Weijie-Lou/DL-14542/project/Hardware/温显UI_T1(转曲）2026092701.pdf

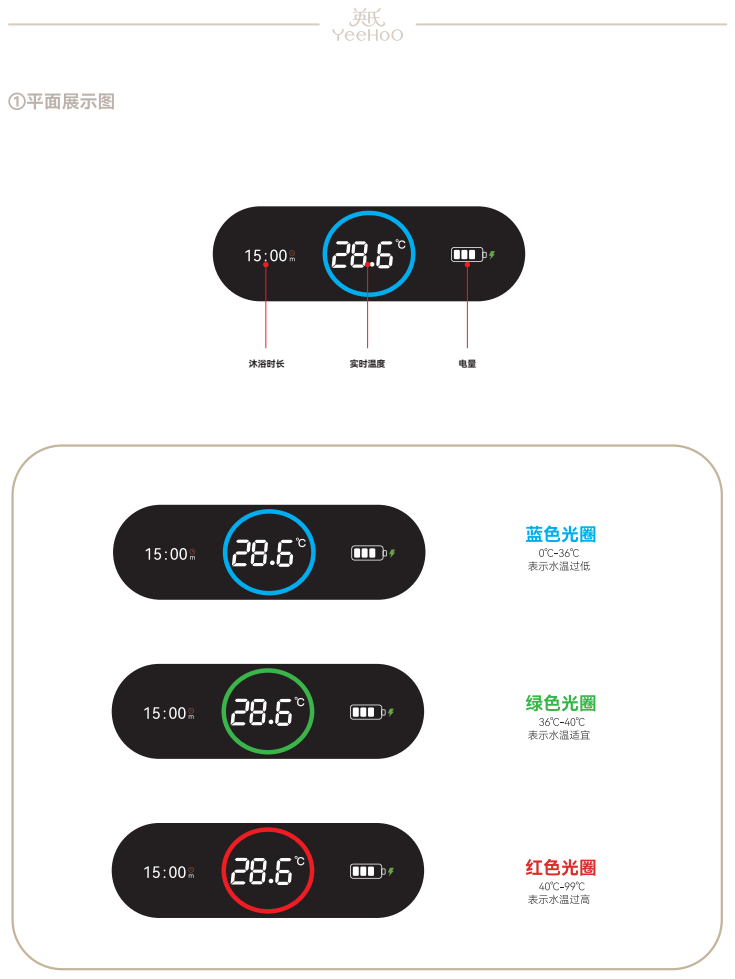
[picture p10: page 1]
沐浴时长; 实时温度

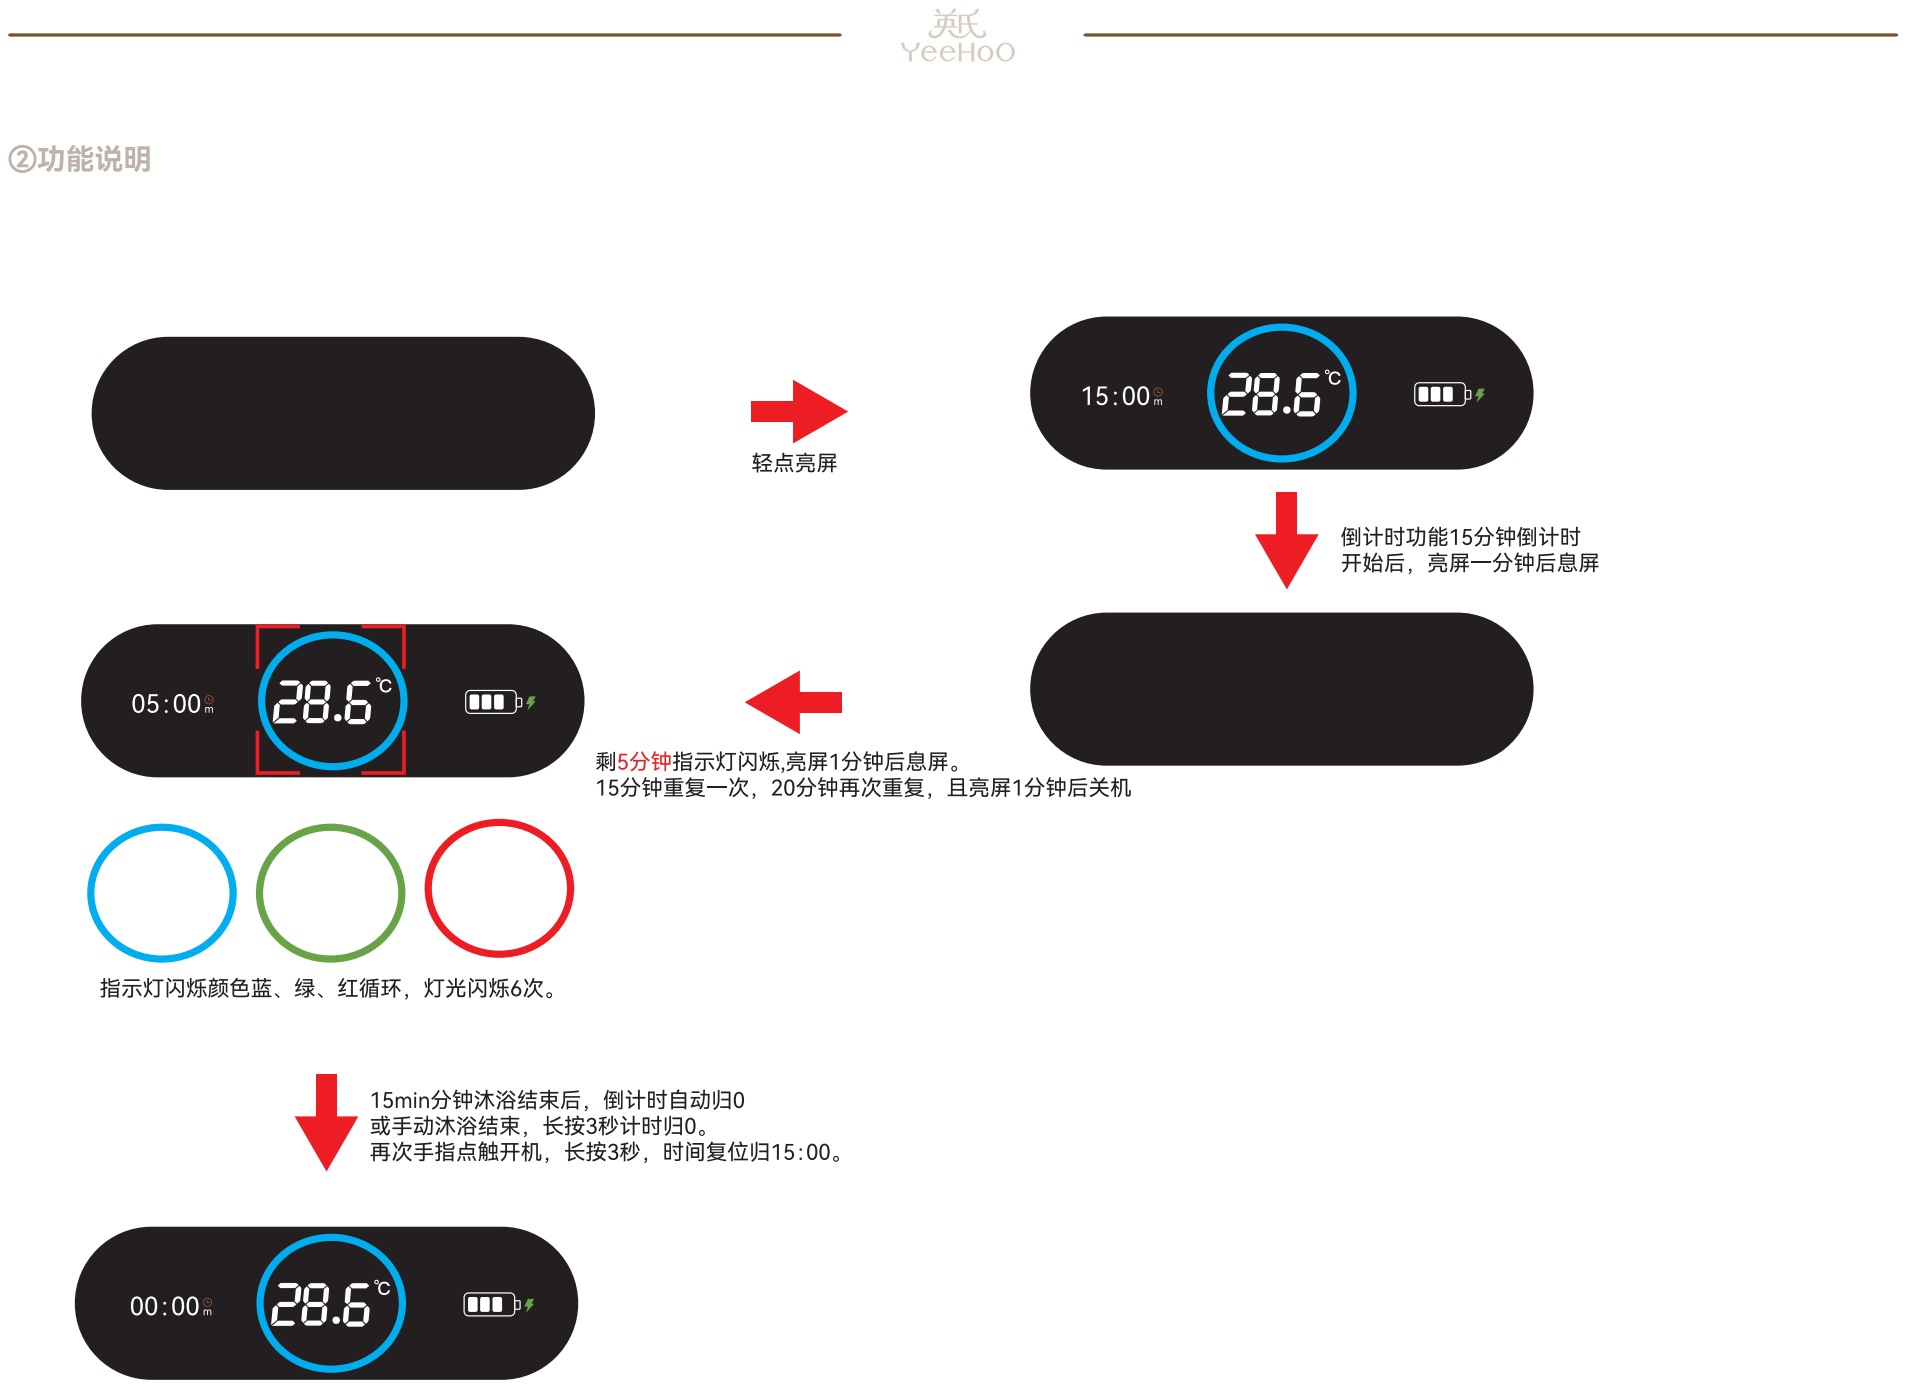
[picture p11: page 2]
