Weijie-Lou/DL-14542/(list of files, drawings)

Other design files:
project/Hardware/DL-14542-V01 20261004.PcbDoc
