Weijie-Lou/DL-14542/project/App/DL-14542/DL-14542/User/adc.c

/**
 * @file    adc.c
 * @brief   NY8BM84A 模数转换(ADC)驱动实现
 * @note
 *   - ADMD  ：ADEN[7] 使能 / START[6] 启动 / GCHS[5] 全局通道 / CHS[4:0] 通道选择
 *   - ADCON1：ADFM[4] 结果格式 / ADCK[3:2] 转换时钟 / VHS[1:0] 参考电压 / EOC 转换完成标志
 *   - ADCR  ：PxCON 端口映射[7:6] / 采样脉冲宽度[3:2] / 转换位数[1:0]
 *   - 转换结果：ADD = (ADDH << 8) | ADDL（12 位）
 */

#include "adc.h"
#include <stdint.h>

/** @brief 初始化 ADC：使能 ADC、选择通道、设置右对齐 / 参考电压 / 转换时钟与 12bit 8Clk 采样
 *  @param ch  采样通道（ADMD[4:0]）
 *  @param ref 参考电压（ADCON1：VHS[1:0] 内部电压 / EVHENB 外部参考）
 *  @param clk 转换时钟（ADCON1：ADCK[3:2]）
 */
void ADC_Init(ADC_Channel_t ch, ADC_Reference_t ref, ADC_Clock_t clk)
{
    ADMD   = C_ADC_En | C_ADC_CH_Dis | ch;   /* 使能 ADC、关闭全局通道、选择通道 */
    ADCON1 = C_ADFM_Right | ref | clk;       /* 结果右对齐 + 参考电压 + 转换时钟 */
    ADCR   = (ADCR & 0xF0u) | C_Sample_8Clk | C_12Bit;  /* 保留 ADCR[7:4]（含 [7:6] PxCON 端口映射，由 GPIO_SET_ANALOG 维护），设采样宽度[3:2]与位数[1:0] */

    ADMDbits.GCHS = 1;                       /* 使能全局 ADC 通道 */
    PIR2bits.ADIF = 0;                       /* 清 ADC 中断标志 */
}

/** @brief 关闭 ADC：ADMD 写 0（清 ADEN 使能与通道选择），避免采样电路常开耗电 */
void ADC_Disable(void)
{
    ADMD = C_ADC_CH_Dis;                     /* ADMD 写 0：关闭 ADEN 使能与通道选择 */
}

/** @brief 启动一次转换并等待完成，返回 12 位结果
 *  @note  查询 EOC 等待（无中断）；超时（约 65535 次空转）时返回上一次的有效结果，
 *         并且首次转换通常需丢弃（切换通道后未稳定），详见 temp.c / battery.c */
uint16_t ADC_Convert(void)
{
    static uint16_t last_result = 0;   /* 上次有效结果（超时保护时返回，避免读数跳变） */
    uint16_t result;
    uint16_t timeout = 0;

    ADMDbits.START = 1;                      /* 启动一次转换 */
    while (ADCON1bits.EOC == 0) {            /* 等待转换完成 */
        if (++timeout == 0u) {               /* 超时保护：约 65535 次空转后放弃，返回上次有效结果 */
            return last_result;
        }
    }
    last_result = result = ((uint16_t)ADDH << 8) | ADDL;   /* 12 位结果 */
    return result;
}
