Weijie-Lou/DL-14542/(commit log)

2026-10-12 代码编辑中
    [DL-14542-V01 20261004.PcbDoc]
2026-10-15 DL-14542 交付固件（校验和 E1271A / NY8BM84A / TSSOP20）
    15 分钟倒计时 + 实时温度显示 + 电量指示；固件代码校验和 E1271A，芯片 NY8BM84A（TSSOP20）。
    新增功能
    - 显示：5 相 2 位数码管改为 12 相动态扫描（SEG1~SEG10 + RGB 灯圈独立引脚），
    支持 3 位温度（0.1℃）、4 位倒计时 MM:SS、冒号 / ℃ / 小数点、电池图标
    （边框 + 5 格电量 + 状态灯），灯圈低电平点亮、约 1/3 占空比
    - 倒计时：长按启动/停止 15 分钟（900s），剩余 5 分钟与结束时各触发一次报警动画
    （冒号闪烁 + 灯圈三色循环，9s 后自动转常显）
    - 温度：NTC 采样单位改为 0.1℃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
2026-10-15 产品说明书提交
